sergesyrota/hvac-zoning/README.md

# HVAC Zoning

System to segment single hvac unit into multiple zones
