sergesyrota/hvac-zoning/eagle/rs-485-module/README.md

# RS-485 module

This module is used for adding RS-485 communication capability to Arduino: https://github.com/sergesyrota/arduino-projects/tree/master/libraries/Rs485-module

V3 large drill is ready to be sent to OSHPark for fabrication, and fits under Arduino Pro Mini using 0.05" pin headers.
