sergesyrota/hvac-zoning/(threads)

Thread 1 (2017-07-08):

Error 0 will not clear

sergesyrota, 2017-07-08:
If error 0 is raised, it will never be cleared (until reboot).

https://github.com/sergesyrota/hvac-zoning/blob/master/arduino/vent/vent.ino#L222

Assignment operator needs to be changed to comparison operator.
