sergesyrota/hvac-zoning/eagle/mainboard/mainboard-augmented-thermostat-v1.brd

## EAGLE design eagle/mainboard/mainboard-augmented-thermostat-v1.brd (2016-04-30)

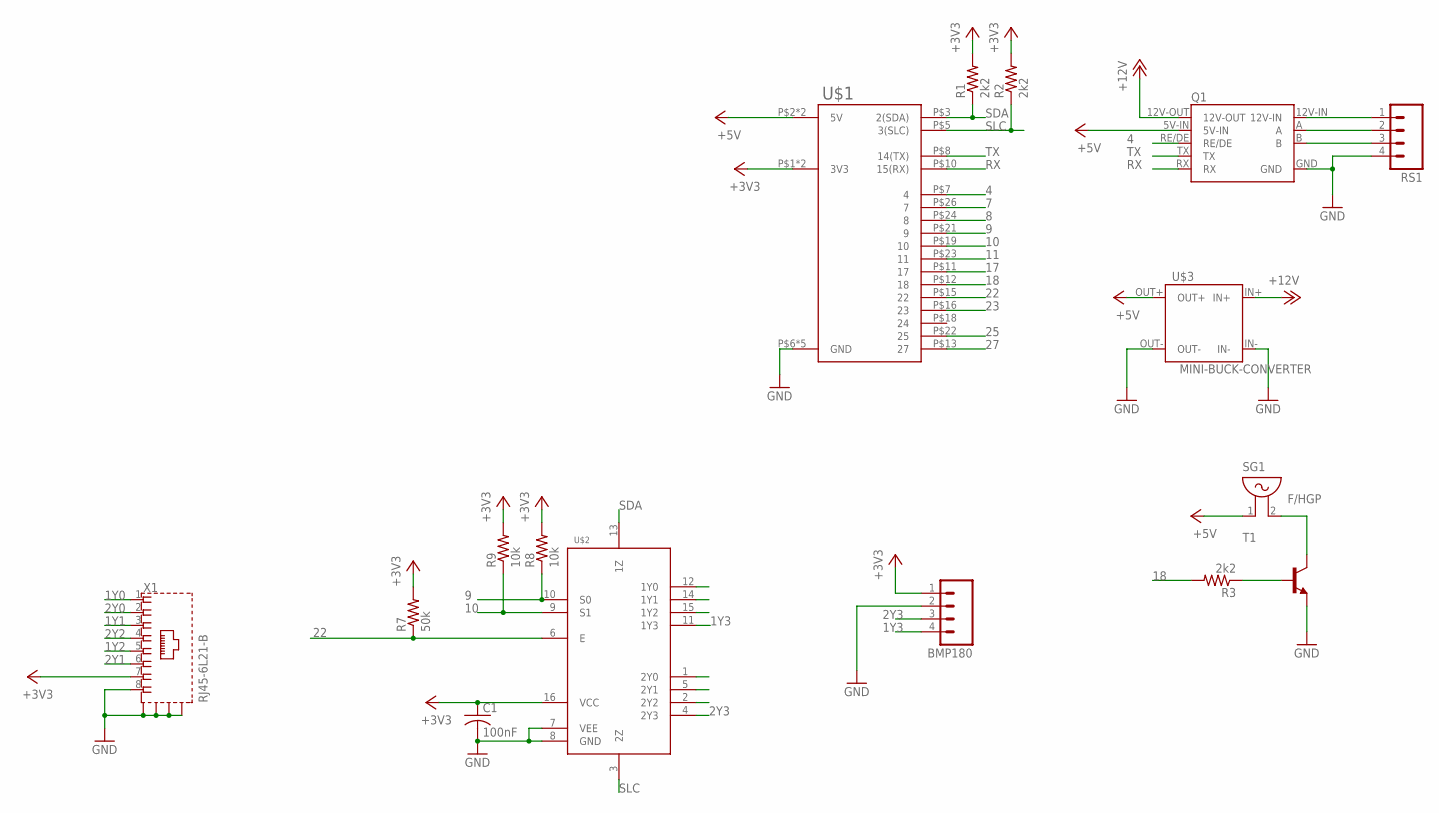
[picture p1: schematic mainboard-augmented-thermostat-v1.sch]

Parts:
BMP180: M04; 04P
C1: 100nF; C0603K
Q1: RS485-ADAPTER0.05-CONNECTOR; RS485-ADAPTOR-05
R1, R2, R3: 2k2; R0603
R7: 50k; R0603
R8, R9: 10k; R0603
RS1: M04; 04P
SG1: F/HGP
T1: BC808-NPN-SOT23-BEC; SOT23-BEC
U$1: RASPI-GPIO; RASPI-GPIO-1
U$2: 74HC4052SO-16; SO16
U$3: MINI-BUCK-CONVERTER
X1: RJ45-6L21-B; RJ45-SHIELD1

Connections:
1Y0: U$2.12 (1Y0), X1.1
1Y1: U$2.14 (1Y1), X1.3
1Y2: U$2.15 (1Y2), X1.5
1Y3: BMP180.4, U$2.11 (1Y3)
2Y0: U$2.1 (2Y0), X1.2
2Y1: U$2.5 (2Y1), X1.6
2Y2: U$2.2 (2Y2), X1.4
2Y3: BMP180.3, U$2.4 (2Y3)
4: Q1.RE/DE, U$1.P$7 (4)
7: U$1.P$26 (7)
8: U$1.P$24 (8)
9: R8.1, U$1.P$21 (9), U$2.10 (S0)
10: R9.1, U$1.P$19 (10), U$2.9 (S1)
11: U$1.P$23 (11)
17: U$1.P$11 (17)
18: R3.2, U$1.P$12 (18)
22: R7.1, U$1.P$15 (22), U$2.6 (E)
23: U$1.P$16 (23)
25: U$1.P$22 (25)
27: U$1.P$13 (27)
+3V3: BMP180.1, C1.1, R1.2, R2.2, R7.2, R8.2, R9.2, U$1.P$1 (3V3), U$1.P$17 (3V3), U$2.16 (VCC), X1.7
+5V: Q1.5V-IN, SG1.1, U$1.P$2 (5V), U$1.P$4 (5V), U$3.OUT+
+12V: Q1.12V-OUT, U$3.IN+
GND: BMP180.2, C1.2, Q1.GND, RS1.4, T1.E, U$1.P$6 (GND), U$1.P$9 (GND), U$1.P$14 (GND), U$1.P$20 (GND), U$1.P$25 (GND), U$2.7 (VEE), U$2.8 (GND), U$3.IN-, U$3.OUT-, X1.8, X1.S1 (S), X1.S2 (S), X1.S3 (S), X1.S4 (S)
unnamed: R3.1, T1.B
unnamed: SG1.2, T1.C
RS-12V: Q1.12V-IN, RS1.1
RS-A: Q1.A, RS1.2
RS-B: Q1.B, RS1.3
RX: Q1.RX, U$1.P$10 (15(RX))
SDA: R1.1, U$1.P$3 (2(SDA)), U$2.13 (1Z)
SLC: R2.1, U$1.P$5 (3(SLC)), U$2.3 (2Z)
TX: Q1.TX, U$1.P$8 (14(TX))

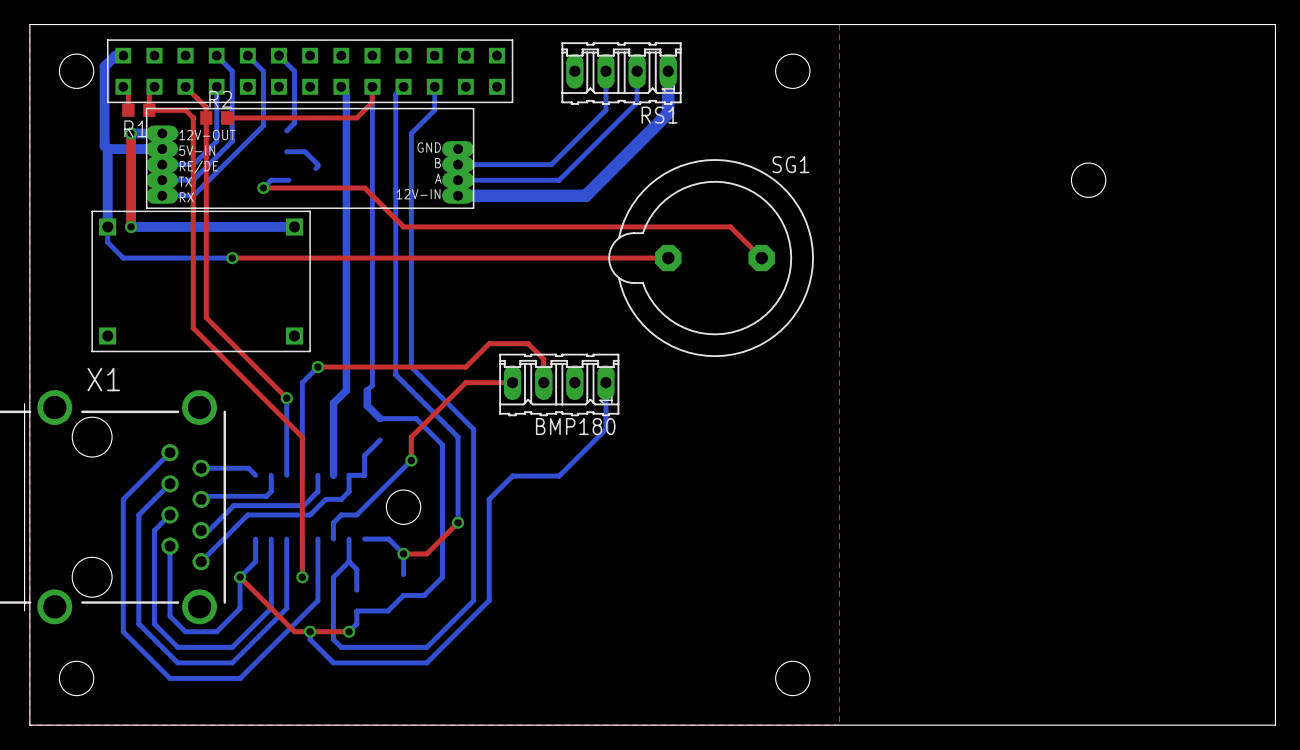
[picture p2: board mainboard-augmented-thermostat-v1.brd from above]

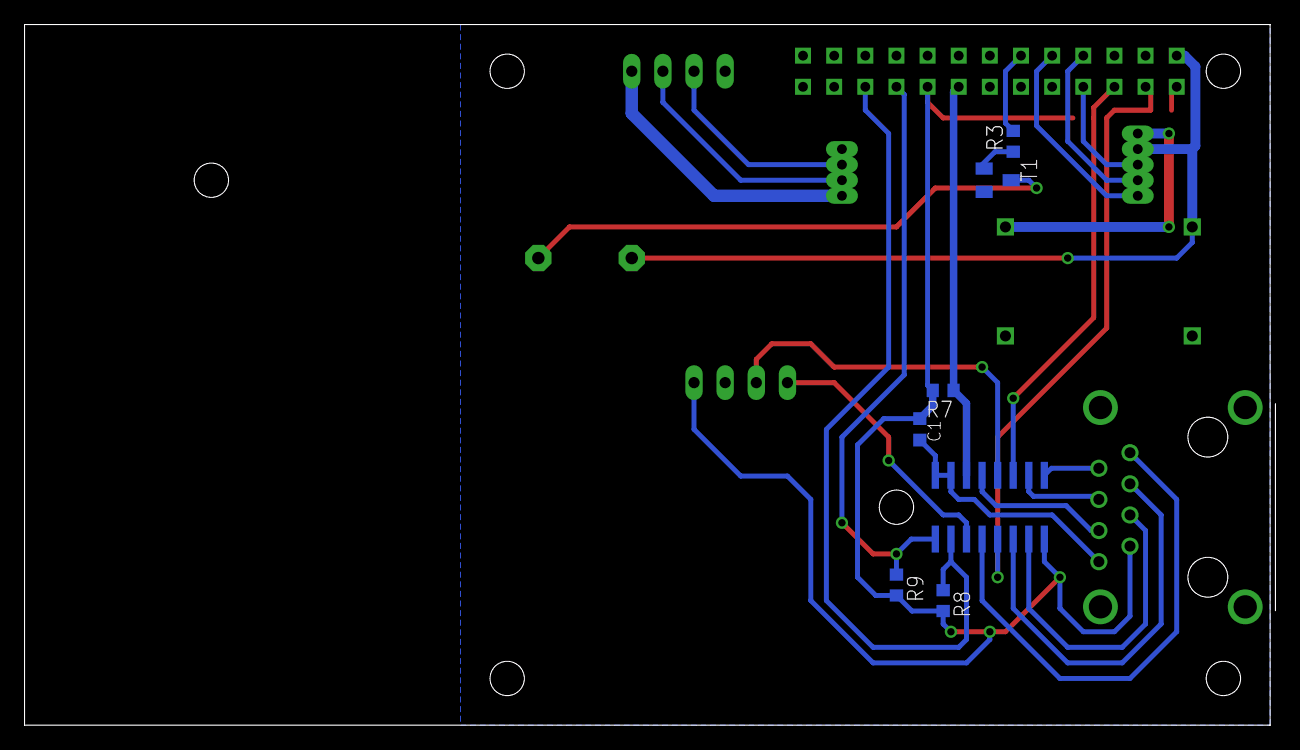
[picture p3: board mainboard-augmented-thermostat-v1.brd from below]

Board: 2 copper layers, 101.6 x 57.1 mm, 16 parts (7 on the bottom side), 26 nets.
