sergesyrota/hvac-zoning/eagle/damper-controller/v1.brd

## EAGLE design eagle/damper-controller/v1.brd (2016-04-13)

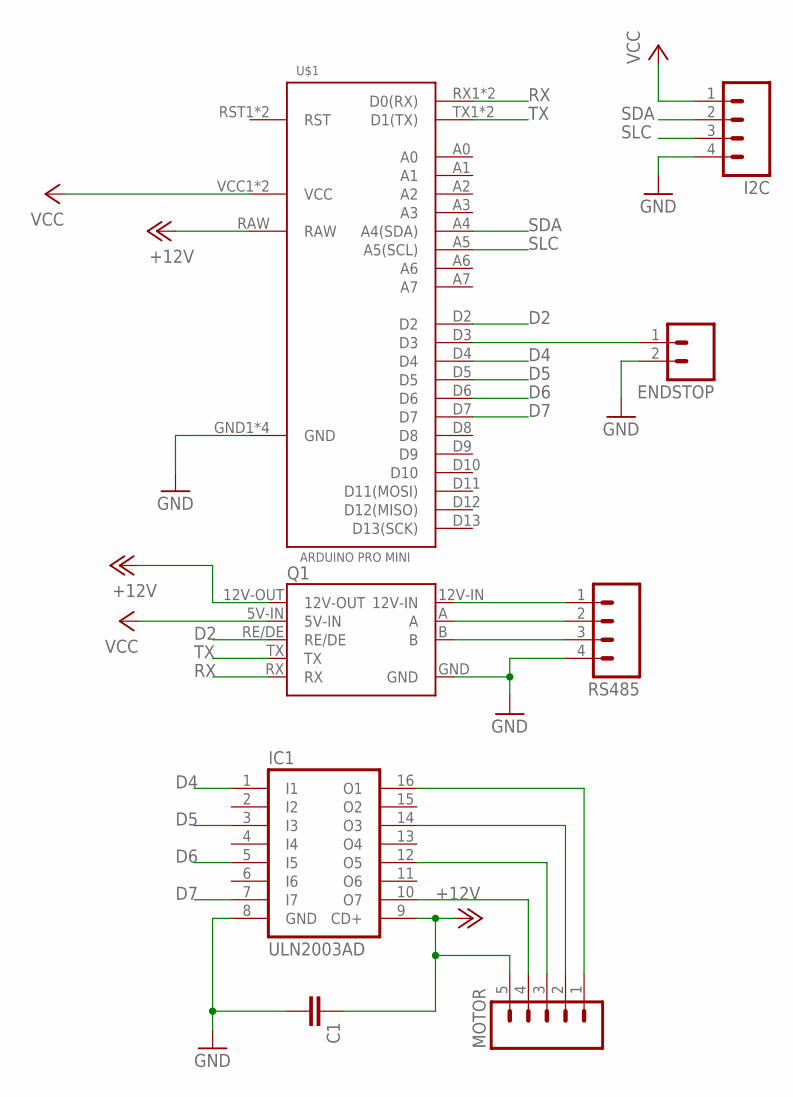
[picture p4: schematic v1.sch]

Parts:
C1: CC0603; C0603
ENDSTOP: M02; 02P
I2C: M04; 04P
IC1: ULN2003AD; SO16
MOTOR: M05; 05P
Q1: RS485-ADAPTER0.05-CONNECTOR; RS485-ADAPTOR-05
RS485: M04; 04P
U$1: ARDUINO-PRO-MINI

Connections:
+12V: C1.1, IC1.9 (CD+), MOTOR.5, Q1.12V-OUT, U$1.RAW
D2: Q1.RE/DE, U$1.D2
D4: IC1.1 (I1), U$1.D4
D5: IC1.3 (I3), U$1.D5
D6: IC1.5 (I5), U$1.D6
D7: IC1.7 (I7), U$1.D7
GND: C1.2, ENDSTOP.2, I2C.4, IC1.8 (GND), Q1.GND, RS485.4, U$1.GND1 (GND), U$1.GND2 (GND), U$1.GND3 (GND), U$1.GND4 (GND)
unnamed: Q1.12V-IN, RS485.1
unnamed: IC1.16 (O1), MOTOR.1
unnamed: IC1.14 (O3), MOTOR.2
unnamed: IC1.12 (O5), MOTOR.3
unnamed: IC1.10 (O7), MOTOR.4
unnamed: Q1.A, RS485.2
unnamed: Q1.B, RS485.3
unnamed: ENDSTOP.1, U$1.D3
RX: Q1.RX, U$1.RX1 (D0(RX)), U$1.RX2 (D0(RX))
SDA: I2C.2, U$1.A4 (A4(SDA))
SLC: I2C.3, U$1.A5 (A5(SCL))
TX: Q1.TX, U$1.TX1 (D1(TX)), U$1.TX2 (D1(TX))
VCC: I2C.1, Q1.5V-IN, U$1.VCC1 (VCC), U$1.VCC2 (VCC)

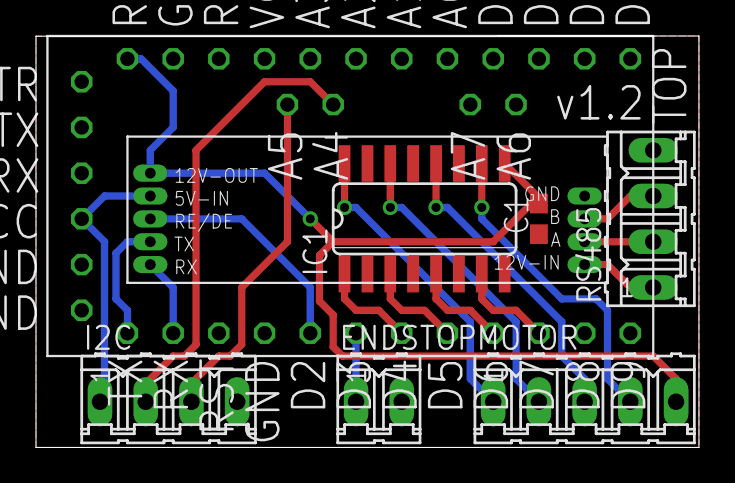
[picture p5: board v1.brd from above]

Board: 2 copper layers, 36.8 x 22.9 mm, 8 parts (0 on the bottom side), 20 nets.
