sergesyrota/hvac-zoning/eagle/rs-485-expansion/expansion-w-power.brd

## EAGLE design eagle/rs-485-expansion/expansion-w-power.brd (2016-03-20)

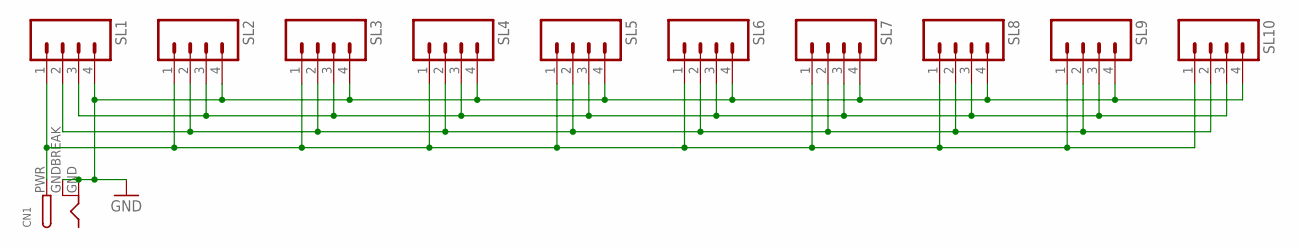
[picture p6: schematic expansion-w-power.sch]

Parts:
CN1: DCBARRELPTH; DCJACK_2MM_PTH
SL1, SL2, SL3, SL4, SL5, SL6, SL7, SL8, SL9, SL10: M04; 04P

Connections:
GND: CN1.GND, CN1.GNDBREAK, SL1.4, SL2.4, SL3.4, SL4.4, SL5.4, SL6.4, SL7.4, SL8.4, SL9.4, SL10.4
unnamed: SL1.3, SL2.3, SL3.3, SL4.3, SL5.3, SL6.3, SL7.3, SL8.3, SL9.3, SL10.3
unnamed: SL1.2, SL2.2, SL3.2, SL4.2, SL5.2, SL6.2, SL7.2, SL8.2, SL9.2, SL10.2
unnamed: CN1.PWR, SL1.1, SL2.1, SL3.1, SL4.1, SL5.1, SL6.1, SL7.1, SL8.1, SL9.1, SL10.1

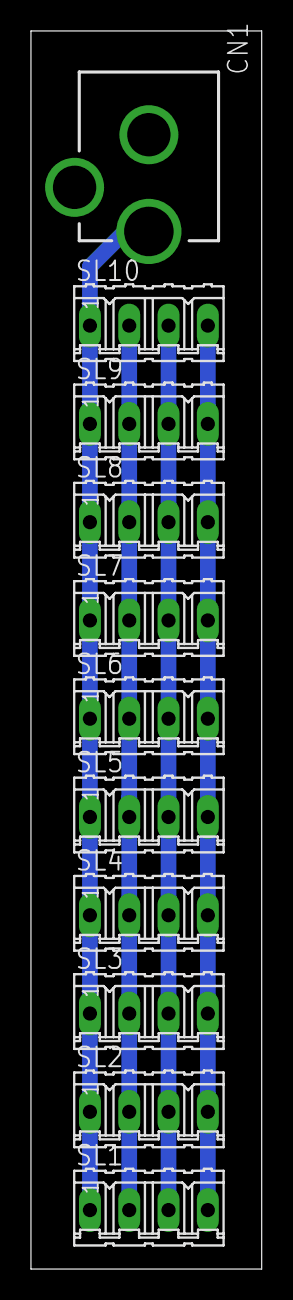
[picture p7: board expansion-w-power.brd from above]

Board: 2 copper layers, 14.9 x 80.0 mm, 11 parts (0 on the bottom side), 4 nets.
