sergesyrota/hvac-zoning/eagle/mainboard/mainboard-v2-opto.brd

## EAGLE design eagle/mainboard/mainboard-v2-opto.brd (2016-03-16)

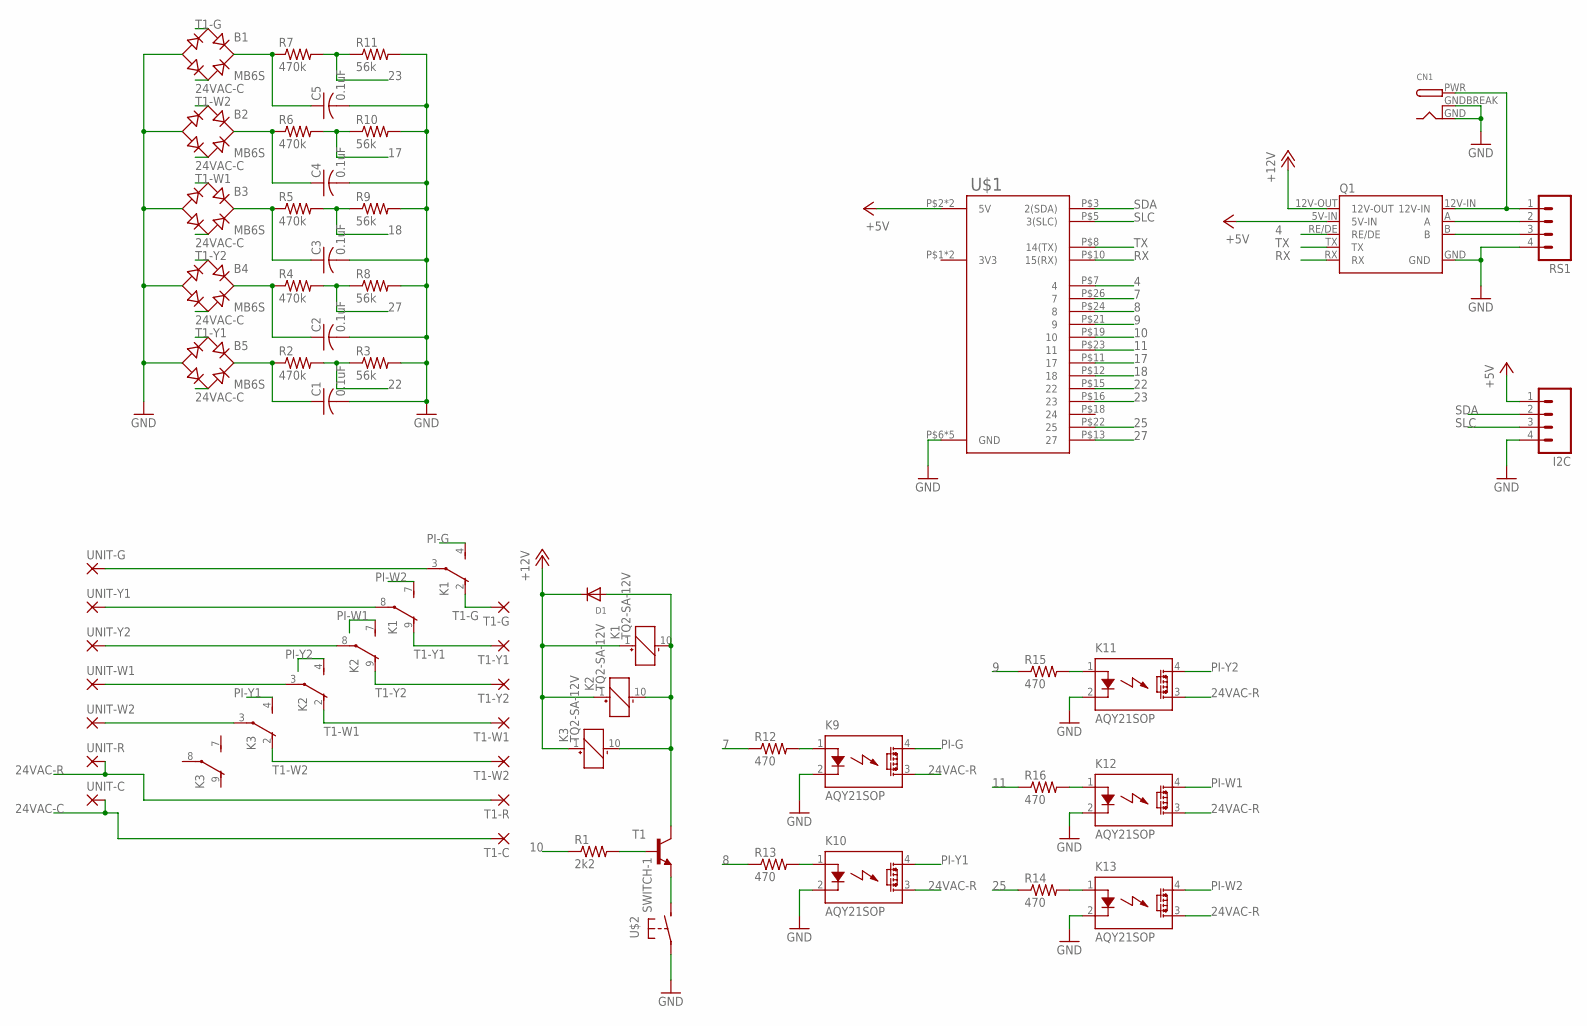
[picture p8: schematic mainboard-v2-opto.sch]

Parts:
B1, B2, B3, B4, B5: MB6S; SOIC-4
C1, C2, C3, C4, C5: 0.1uF; C0603
CN1: DCBARRELPTH; DCJACK_2MM_PTH
D1: DIODESMA; SMADIODE
I2C: M04; 04P
K1, K2, K3: TQ2-SA-12V; TQ-SA
K9, K10, K11, K12, K13: AQY21SOP; SOP04
Q1: RS485-ADAPTER0.05-CONNECTOR; RS485-ADAPTOR-05
R1: 2k2; R0603
R2, R4, R5, R6, R7: 470k; R0603
R3, R8, R9, R10, R11: 56k; R0603
R12, R13, R14, R15, R16: 470; R0603
RS1: M04; 04P
T1: BC808-NPN-SOT23-BEC; SOT23-BEC
T1-C, T1-G, T1-R, T1-W1, T1-W2, T1-Y1, T1-Y2: 2,15/1,0
U$1: RASPI-GPIO; RASPI-GPIO-1
U$2: SWITCH-1
UNIT-C: 2,15/1,0
UNIT-G: 2,15/1,0
UNIT-R: 2,15/1,0
UNIT-W1, UNIT-W2: 2,15/1,0
UNIT-Y1, UNIT-Y2: 2,15/1,0

Connections:
3V3: U$1.P$1 (3V3), U$1.P$17 (3V3)
4: Q1.RE/DE, U$1.P$7 (4)
7: R12.1, U$1.P$26 (7)
8: R13.1, U$1.P$24 (8)
9: R15.1, U$1.P$21 (9)
10: R1.1, U$1.P$19 (10)
11: R16.1, U$1.P$23 (11)
17: R6.2, R10.1, U$1.P$11 (17)
18: R5.2, R9.1, U$1.P$12 (18)
22: R2.2, R3.1, U$1.P$15 (22)
23: R7.2, R11.1, U$1.P$16 (23)
24VAC-C: B1.~2 (AC2), B2.~2 (AC2), B3.~2 (AC2), B4.~2 (AC2), B5.~2 (AC2), T1-C.1, UNIT-C.1
24VAC-R: K9.3 (DS2), K10.3 (DS2), K11.3 (DS2), K12.3 (DS2), K13.3 (DS2), T1-R.1, UNIT-R.1
25: R14.1, U$1.P$22 (25)
27: R4.2, R8.1, U$1.P$13 (27)
+5V: I2C.1, Q1.5V-IN, U$1.P$2 (5V), U$1.P$4 (5V)
+12V: D1.C, K1.1 (+), K2.1 (+), K3.1 (+), Q1.12V-OUT
GND: B1.-, B2.-, B3.-, B4.-, B5.-, C1.2, C2.2, C3.2, C4.2, C5.2, CN1.GND, CN1.GNDBREAK, I2C.4, K9.2 (K), K10.2 (K), K11.2 (K), K12.2 (K), K13.2 (K), Q1.GND, R3.2, R8.2, R9.2, R10.2, R11.2, RS1.4, U$1.P$6 (GND), U$1.P$9 (GND), U$1.P$14 (GND), U$1.P$20 (GND), U$1.P$25 (GND), U$2.P$1
unnamed: B5.+, C1.1, R2.1
unnamed: K1.3, UNIT-G.1
unnamed: K1.8, UNIT-Y1.1
unnamed: K2.8, UNIT-Y2.1
unnamed: D1.A, K1.10 (-), K2.10 (-), K3.10 (-), T1.C
unnamed: R1.2, T1.B
unnamed: K2.3, UNIT-W1.1
unnamed: K13.1 (A), R14.2
unnamed: K3.3, UNIT-W2.1
unnamed: B1.+, C5.1, R7.1
unnamed: K12.1 (A), R16.2
unnamed: K11.1 (A), R15.2
unnamed: B4.+, C2.1, R4.1
unnamed: B3.+, C3.1, R5.1
unnamed: T1.E, U$2.P$2 (S)
unnamed: K9.1 (A), R12.2
unnamed: K10.1 (A), R13.2
unnamed: B2.+, C4.1, R6.1
PI-G: K1.4 (S), K9.4 (DS1)
PI-W1: K2.7 (S), K12.4 (DS1)
PI-W2: K1.7 (S), K13.4 (DS1)
PI-Y1: K3.4 (S), K10.4 (DS1)
PI-Y2: K2.4 (S), K11.4 (DS1)
RS-12V: CN1.PWR, Q1.12V-IN, RS1.1
RS-A: Q1.A, RS1.2
RS-B: Q1.B, RS1.3
RX: Q1.RX, U$1.P$10 (15(RX))
SDA: I2C.2, U$1.P$3 (2(SDA))
SLC: I2C.3, U$1.P$5 (3(SLC))
T1-G: B1.~1 (AC1), K1.2 (O), T1-G.1
T1-W1: B3.~1 (AC1), K2.2 (O), T1-W1.1
T1-W2: B2.~1 (AC1), K3.2 (O), T1-W2.1
T1-Y1: B5.~1 (AC1), K1.9 (O), T1-Y1.1
T1-Y2: B4.~1 (AC1), K2.9 (O), T1-Y2.1
TX: Q1.TX, U$1.P$8 (14(TX))

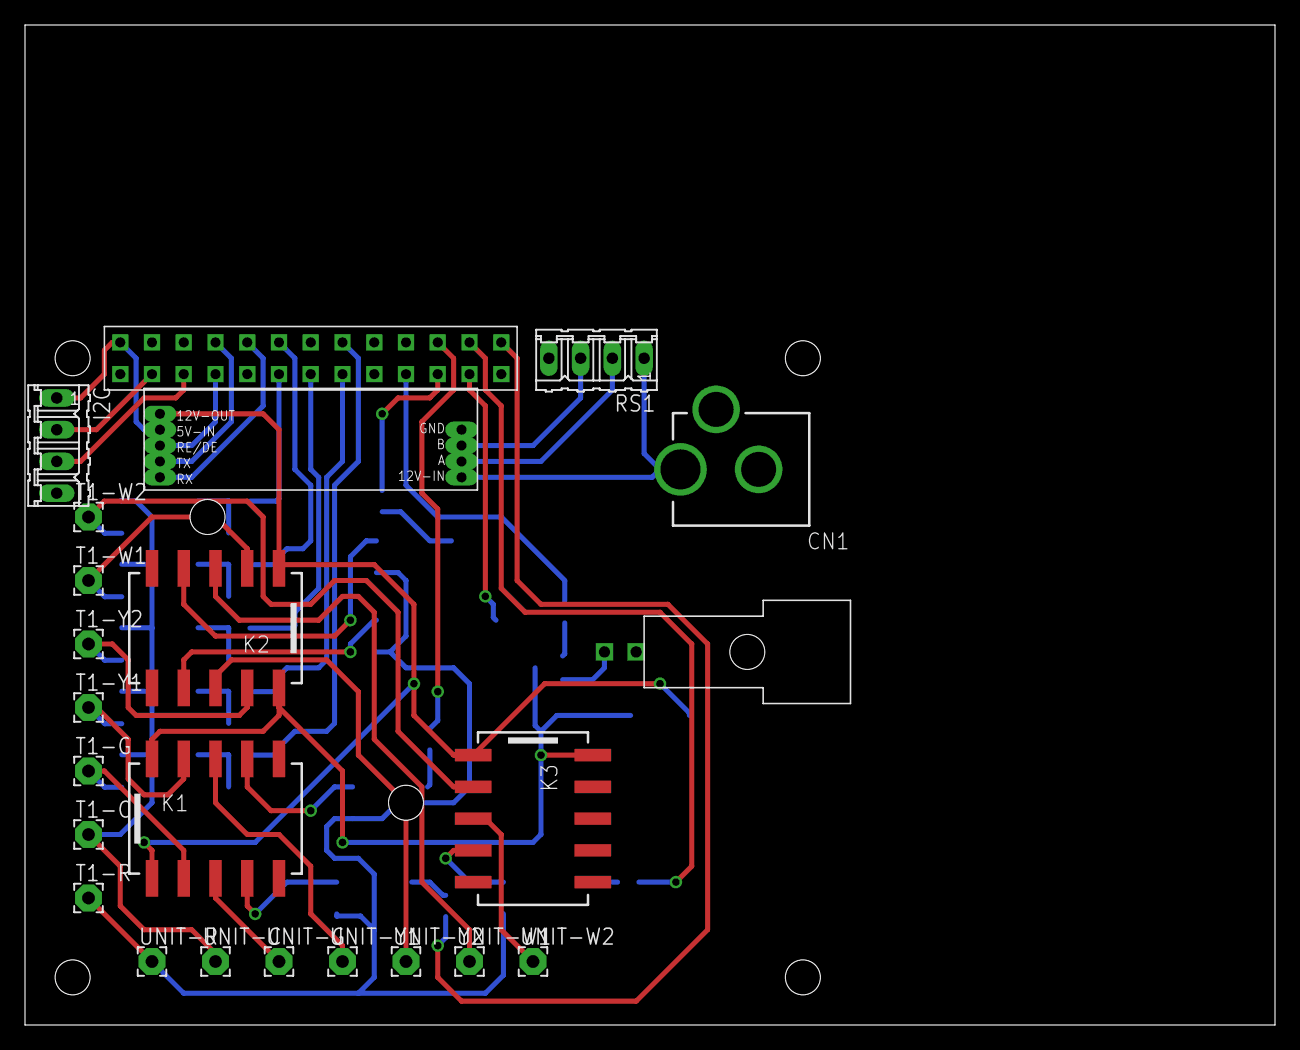
[picture p9: board mainboard-v2-opto.brd from above]

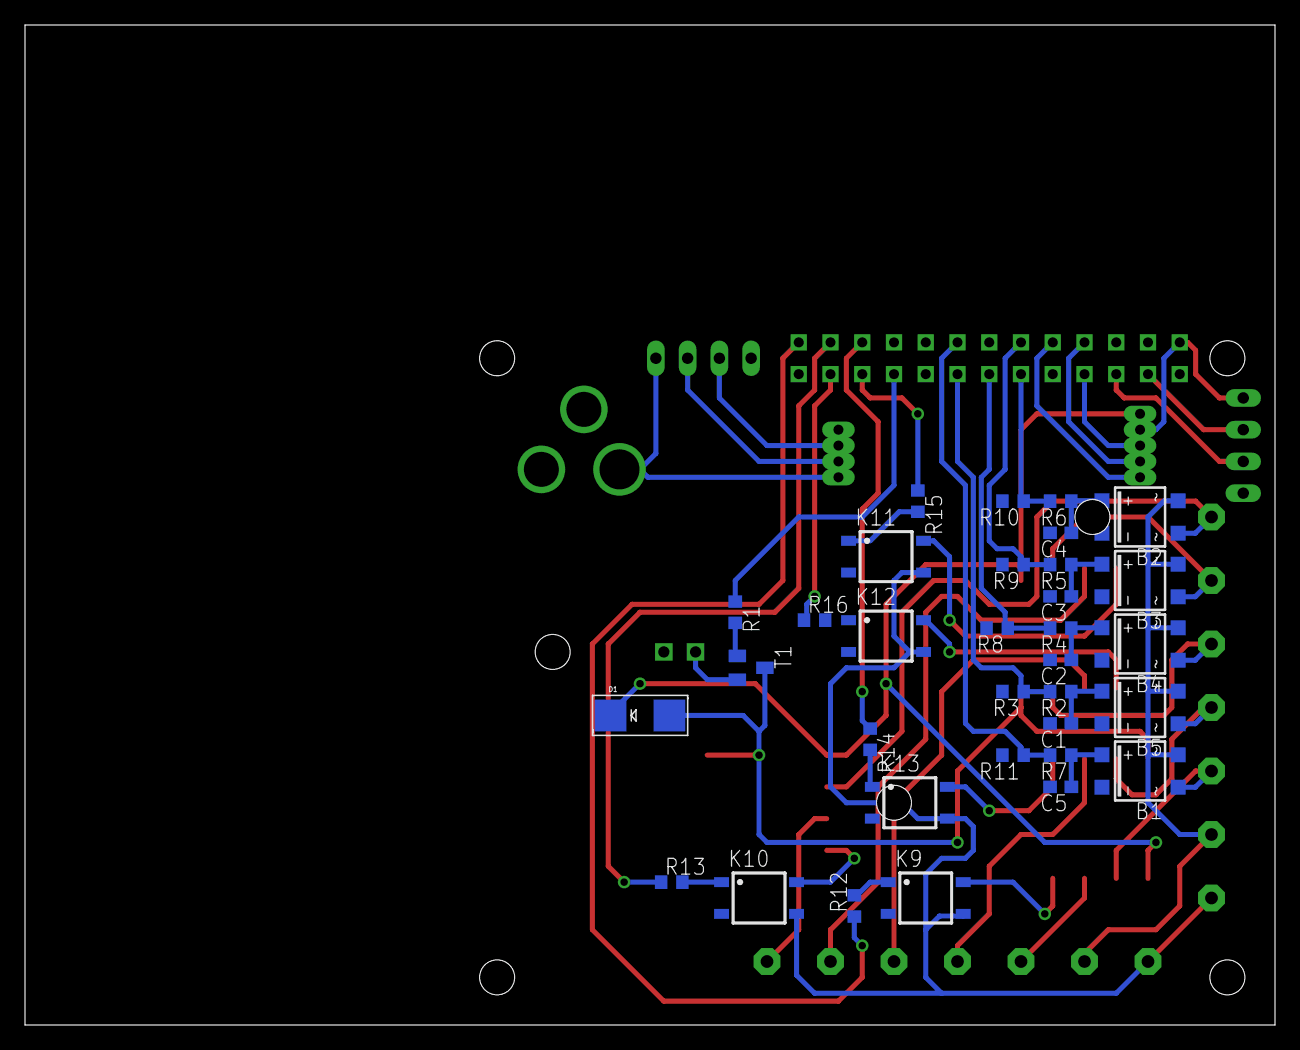
[picture p10: board mainboard-v2-opto.brd from below]

Board: 2 copper layers, 100.0 x 80.0 mm, 56 parts (33 on the bottom side), 53 nets.
