sergesyrota/hvac-zoning/eagle/mainboard/mainboard-v1.brd

## EAGLE design eagle/mainboard/mainboard-v1.brd (2016-03-13)

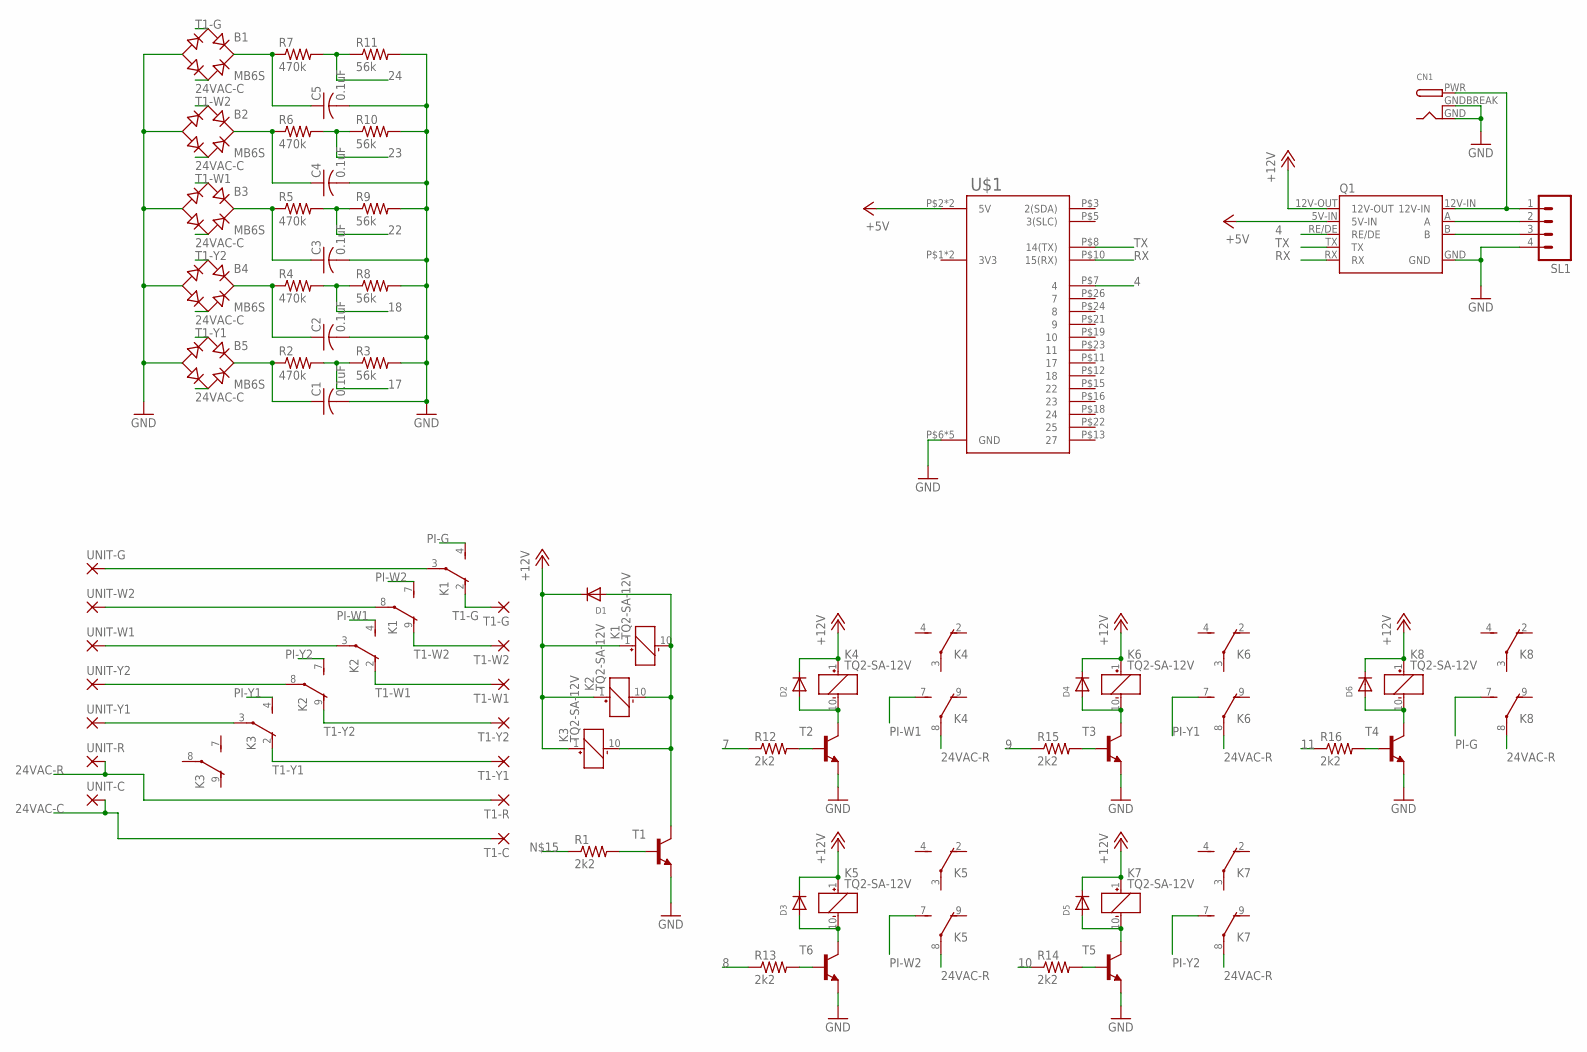
[picture p11: schematic mainboard-v1.sch]

Parts:
B1, B2, B3, B4, B5: MB6S; SOIC-4
C1, C2, C3, C4, C5: 0.1uF; C0603
CN1: DCBARRELPTH; DCJACK_2MM_PTH
D1, D2, D3, D4, D5, D6: DIODESMA; SMADIODE
K1, K2, K3, K4, K5, K6, K7, K8: TQ2-SA-12V; TQ-SA
Q1: RS485-ADAPTER0.05-CONNECTOR; RS485-ADAPTOR-05
R1, R12, R13, R14, R15, R16: 2k2; R0603
R2, R4, R5, R6, R7: 470k; R0603
R3, R8, R9, R10, R11: 56k; R0603
SL1: M04; 04P
T1, T2, T3, T4, T5, T6: BC808-NPN-SOT23-BEC; SOT23-BEC
T1-C, T1-G, T1-R, T1-W1, T1-W2, T1-Y1, T1-Y2: 1,6/0,9
U$1: RASPI-GPIO; RASPI-GPIO-1
UNIT-C: 1,6/0,9
UNIT-G: 1,6/0,9
UNIT-R: 1,6/0,9
UNIT-W1, UNIT-W2: 1,6/0,9
UNIT-Y1, UNIT-Y2: 1,6/0,9

Connections:
3V3: U$1.P$1 (3V3), U$1.P$17 (3V3)
4: Q1.RE/DE, U$1.P$7 (4)
7: R12.1
8: R13.1
9: R15.1
10: R14.1
11: R16.1
17: R2.2, R3.1
18: R4.2, R8.1
22: R5.2, R9.1
23: R6.2, R10.1
24: R7.2, R11.1
24VAC-C: B1.~2 (AC2), B2.~2 (AC2), B3.~2 (AC2), B4.~2 (AC2), B5.~2 (AC2), T1-C.1, UNIT-C.1
24VAC-R: K4.8, K5.8, K6.8, K7.8, K8.8, T1-R.1, UNIT-R.1
+5V: Q1.5V-IN, U$1.P$2 (5V), U$1.P$4 (5V)
+12V: D1.C, D2.C, D3.C, D4.C, D5.C, D6.C, K1.1 (+), K2.1 (+), K3.1 (+), K4.1 (+), K5.1 (+), K6.1 (+), K7.1 (+), K8.1 (+), Q1.12V-OUT
GND: B1.-, B2.-, B3.-, B4.-, B5.-, C1.2, C2.2, C3.2, C4.2, C5.2, CN1.GND, CN1.GNDBREAK, Q1.GND, R3.2, R8.2, R9.2, R10.2, R11.2, SL1.4, T1.E, T2.E, T3.E, T4.E, T5.E, T6.E, U$1.P$6 (GND), U$1.P$9 (GND), U$1.P$14 (GND), U$1.P$20 (GND), U$1.P$25 (GND)
unnamed: B5.+, C1.1, R2.1
unnamed: K1.3, UNIT-G.1
unnamed: K1.8, UNIT-W2.1
unnamed: D1.A, K1.10 (-), K2.10 (-), K3.10 (-), T1.C
unnamed: R1.2, T1.B
unnamed: K3.3, UNIT-Y1.1
unnamed: K2.8, UNIT-Y2.1
unnamed: K2.3, UNIT-W1.1
unnamed: B1.+, C5.1, R7.1
unnamed: B4.+, C2.1, R4.1
unnamed: B3.+, C3.1, R5.1
unnamed: B2.+, C4.1, R6.1
unnamed: CN1.PWR, Q1.12V-IN, SL1.1
unnamed: D2.A, K4.10 (-), T2.C
unnamed: Q1.A, SL1.2
unnamed: Q1.B, SL1.3
unnamed: D3.A, K5.10 (-), T6.C
unnamed: D5.A, K7.10 (-), T5.C
unnamed: D4.A, K6.10 (-), T3.C
unnamed: D6.A, K8.10 (-), T4.C
unnamed: R13.2, T6.B
unnamed: R12.2, T2.B
unnamed: R15.2, T3.B
unnamed: R14.2, T5.B
unnamed: R16.2, T4.B
PI-G: K1.4 (S), K8.7 (S)
PI-W1: K2.4 (S), K4.7 (S)
PI-W2: K1.7 (S), K5.7 (S)
PI-Y1: K3.4 (S), K6.7 (S)
PI-Y2: K2.7 (S), K7.7 (S)
RX: Q1.RX, U$1.P$10 (15(RX))
T1-G: B1.~1 (AC1), K1.2 (O), T1-G.1
T1-W1: B3.~1 (AC1), K2.2 (O), T1-W1.1
T1-W2: B2.~1 (AC1), K1.9 (O), T1-W2.1
T1-Y1: B5.~1 (AC1), K3.2 (O), T1-Y1.1
T1-Y2: B4.~1 (AC1), K2.9 (O), T1-Y2.1
TX: Q1.TX, U$1.P$8 (14(TX))

Board: 2 copper layers, 64 parts (0 on the bottom side), 49 nets, no tracks yet.
