sergesyrota/hvac-zoning/(commit log)

2016-02-10 First version of damper controller board.
    [v1.brd, v1.sch]
2016-02-10 Adding models for opposite ends vent mark tool and stepper mount adaptor.
    [vent-5v-stepper-adaptor.scad, vent-damper-mark-tool.scad]
2016-03-06 Finished damper controller, and modified for OSH Park print, instead of home-made method
    [v1.brd, v1.sch]
2016-03-13 Adjusting motor shaft model further
    [vent-5v-stepper-adaptor.scad]
2016-03-13 Adjusting damper controller board based on first prototype of PCB. Needed to move switch connector, and removed LED, as there is no space.
    [v1.brd, v1.sch]
2016-03-13 Starting work on mainboard. Too many relays!
    [mainboard-v1.brd, mainboard-v1.sch]
2016-03-15 Starting work on solid state relay version of mainboard, as it's much more manageable (albeit still painful)
    [mainboard-v2-opto.brd, mainboard-v2-opto.sch]
2016-03-16 Really close to finishing first prototype of the motherboard.
    [mainboard-v2-opto.brd, mainboard-v2-opto.sch]
2016-03-20 Added different spin on mainboard: one that will augment existing wifi thermostat, rather than take over control.
    [mainboard-augmented-thermostat-v1.brd, mainboard-augmented-thermostat-v1.sch]
2016-03-20 Added RS485 10-connector expansion board, with power input.
    [expansion-w-power.brd, expansion-w-power.sch]
2016-03-20 Created blank Eagle project for environment sensor.
2016-03-22 Starting to develop mini stepper library.
2016-04-06 Added ability to get current position to mini stepper library
2016-04-06 Tried adding CPU mount to vent bracket, did not work out. Adjusted positioning of a switch a bit, though.
    [vent-5v-stepper-adaptor.scad]
2016-04-06 Adding CPU enclosure 3d model
    [vent-cpu-mount.scad]
2016-04-13 Rudimentary environment sensor to begin testing.
2016-04-13 Added BMP160 mount model
    [bmp160-mount.scad]
2016-04-13 Added variable to have square duct mount adaptor, instead of round
    [vent-5v-stepper-adaptor.scad]
2016-04-13 Adjusted damper controller so that connectors have enough clearence, and added text to indicate version.
    [v1.brd]
2016-04-13 Added fourth DMP180 sensor, right on the mainboard, so that we can compare to ambient pressure, if we need to.
    [mainboard-augmented-thermostat-v1.brd, mainboard-augmented-thermostat-v1.sch]
2016-04-30 Added buzzer to the mainboard. Ready for first prototype!
    [mainboard-augmented-thermostat-v1.brd, mainboard-augmented-thermostat-v1.sch]
2016-12-04 Vent adaptor fixes
    [vent-5v-stepper-adaptor.scad]
2016-12-04 Fixing environment sensor JSON string
    [environment-sensor.ino]
2016-12-06 Adding calibration possibility to the environment sensor
2017-05-19 Implementing guest bedroom temperature control.
2018-02-19 Added leaving all vents open if system is neither actively heating nor cooling.
2018-02-20 Added a delay between vent move execution (useful if all vents are on the same power source, which might not have enough juice to drive all motors at the same time)
2018-02-20 Added actual sensor implementations for temperature sensors for CLI thermostats.
2018-02-20 Removing debug output from south temp probe.
2018-03-08 Starting to work on an ability to set temperature with nest API. Added a bunch of documentation to functions. Refactored curl calls to be able to reuse the function.
2018-03-08 Added ability to set targets for nest thermostat. Added temperature units conversion to delta function. Added bunch of documentation.
2018-03-08 Adding logic to override master if other zones are calling for heat/cool while master is not doing anything.
2018-03-11 Implemented setting temperature for NEST thermostat
2018-03-11 Fixing a bug that prevented proper hash from being taken for thermostat due to old data (data not refreshed after changing target temperature)
2019-12-11 Adding going to default position when degrees command has not been called in timeout period (e.g. when controller stops working, this will open up the vent after timeout). Also adding reset function.
    [config.h, vent.ino]
2019-12-14 Adding position timeout functionality and reset command
    [environment-sensor.ino, vent.ino]
2020-07-26 Adding current state for bedrooms, and ability to reset override status.
2023-06-03 Adjusting floor heat price
2023-06-08 Fixing setting of temperatures with homebridge, as API update is not instanteneous.
2024-08-09 Adding config variable for checking vent errors, in case we have to fly blind for a bit
2024-08-12 Restricting self-healing to once per 2 hours, in case we have a fully stuck vent that can't do anything.
